njlin664/4-LayerPCB/hardware/README.md

Schematic:


PCB:
