njlin664/4-LayerPCB/docs/ad-4LPCB-2Dview.png

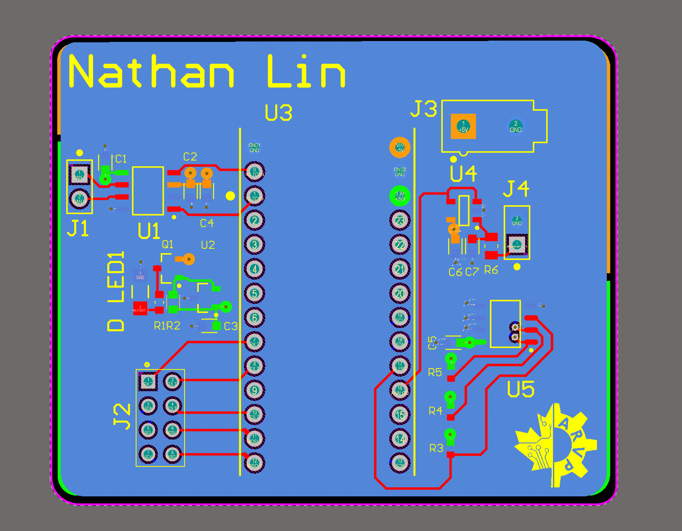
docs/ad-4LPCB-2Dview.png
