njlin664/4-LayerPCB/docs/ad-4LPCB-3Dback.png

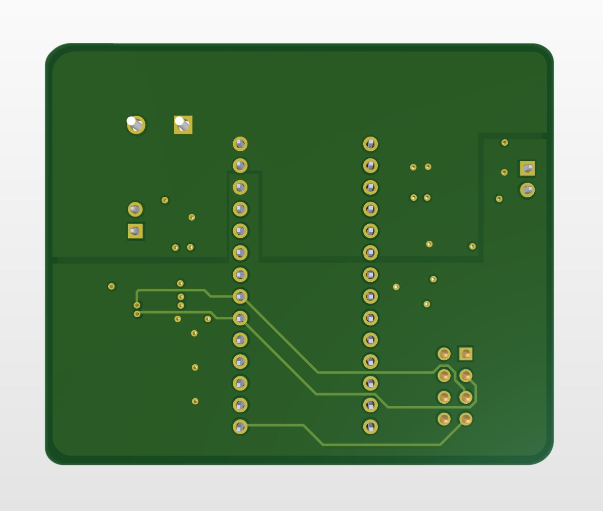
docs/ad-4LPCB-3Dback.png
