njlin664/4-LayerPCB/docs/ad-4LPCB-PCB.png

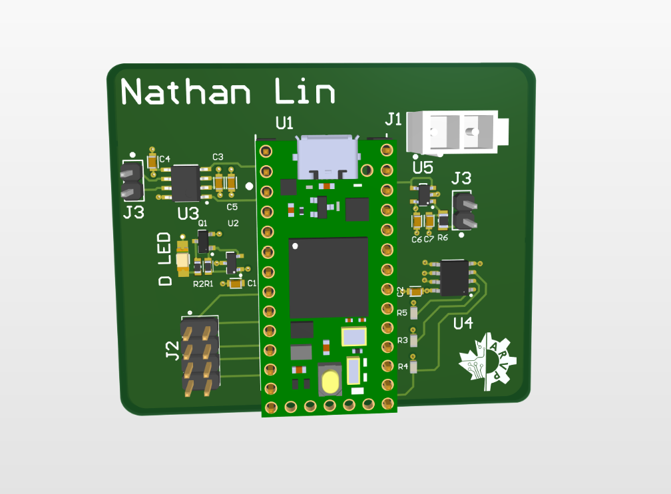
docs/ad-4LPCB-PCB.png
