njlin664/4-LayerPCB/docs/Screenshot 2026-10-11 235438.png

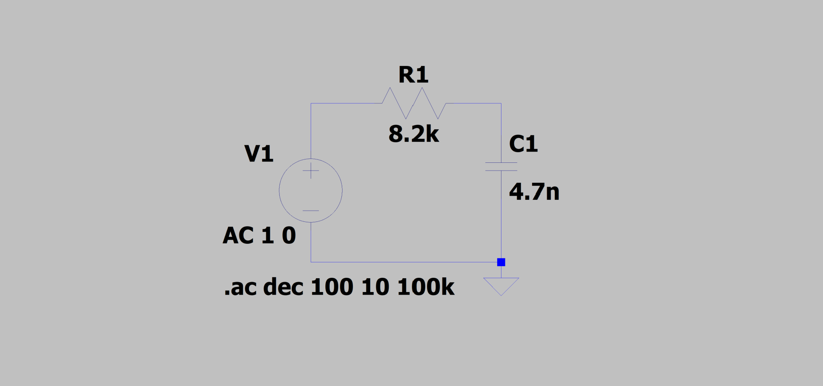
docs/Screenshot 2026-10-11 235438.png
