njlin664/4-LayerPCB/docs/Screenshot 2026-10-12 003222.png

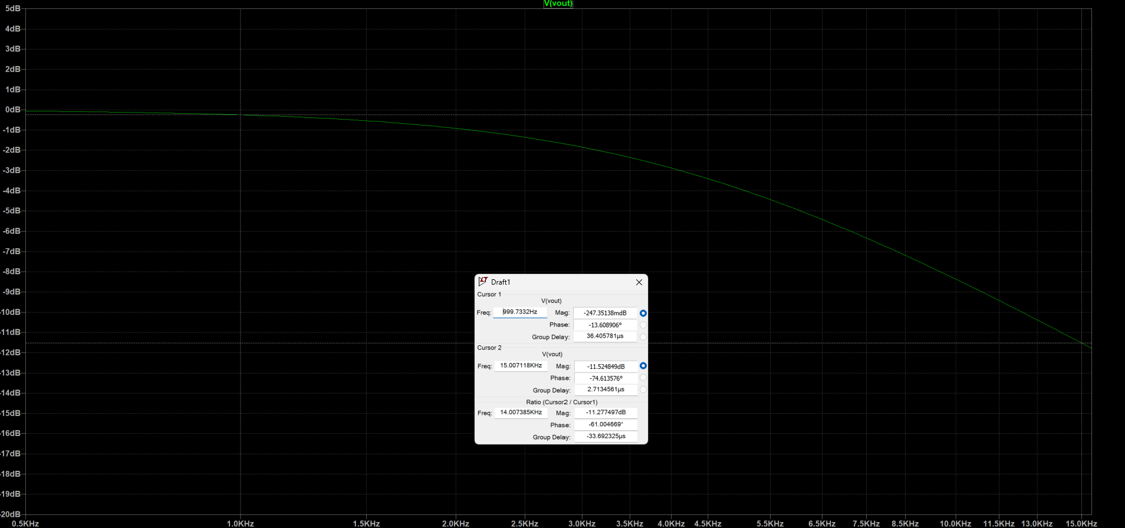
docs/Screenshot 2026-10-12 003222.png
