njlin664/4-LayerPCB/docs/Screenshot 2026-10-12 012424.png

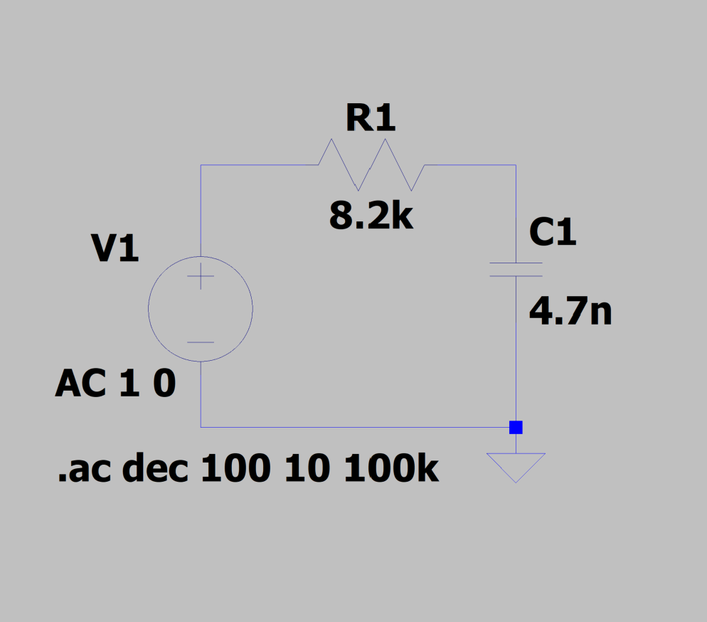
docs/Screenshot 2026-10-12 012424.png
