njlin664/4-LayerPCB/docs/Screenshot 2026-10-12 013154.png

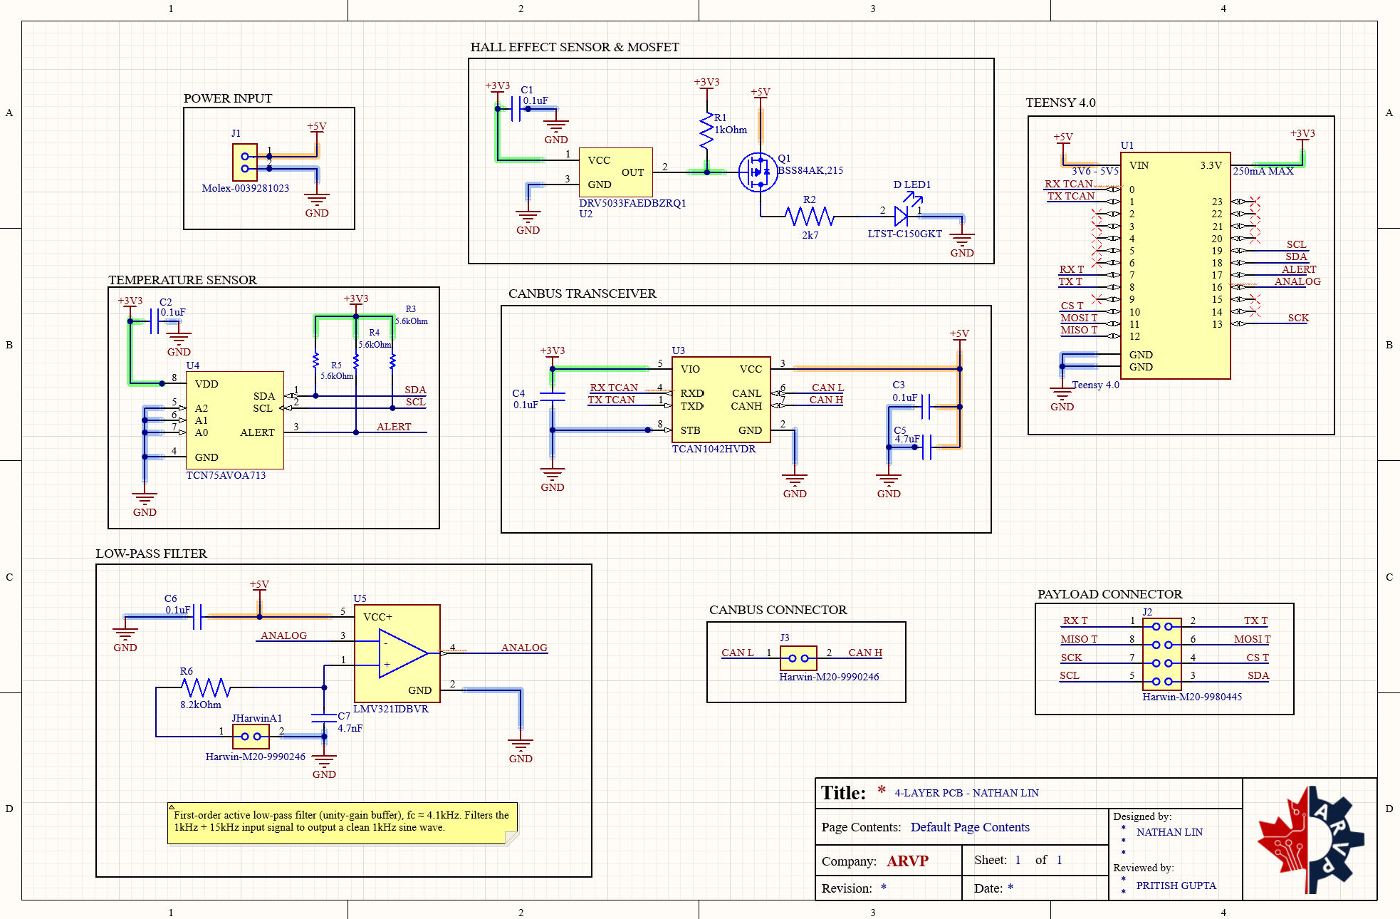
docs/Screenshot 2026-10-12 013154.png
