njlin664/4-LayerPCB/docs/Screenshot 2026-10-12 102839.png

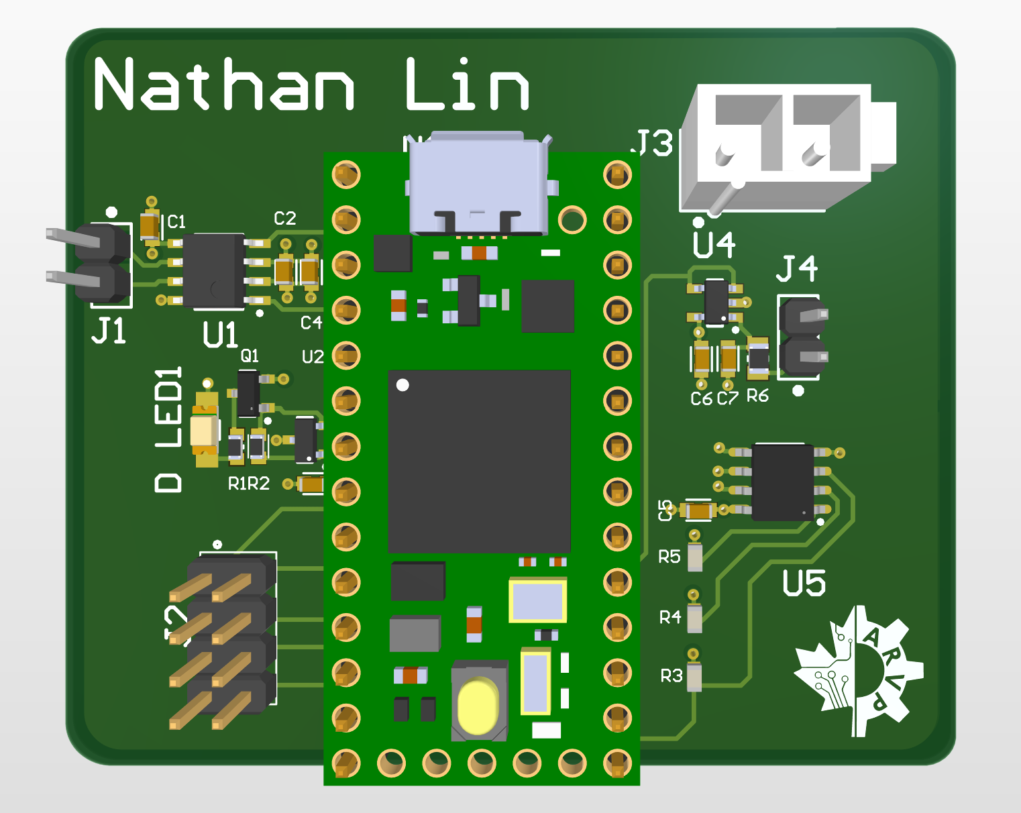
docs/Screenshot 2026-10-12 102839.png
