njlin664/4-LayerPCB/Draft1.asc

C1: cap; 4.7n
R1: res; 8.2k
V1: voltage; ""; AC 1 0
Named nets: 0, Vout
.ac dec 100 10 100k
