njlin664/4-LayerPCB/(list of files, drawings)

Other design files:
hardware/onboarding_nathanlin.PrjPcb
Table of Contents/Schematic_nathanlin.SchDoc
