njlin664/4-LayerPCB/(commit log)

2026-10-06 Update and rename projects/arvp/BOM.csv to Table of Contents/BOM.csv
2026-10-06 Rename projects/arvp/PCB_nathanlin.PcbDoc to Table of Contents/PCB_nathanlin.PcbDoc
2026-10-06 Rename projects/arvp/Schematic_nathanlin.SchDoc to Table of Contents/Schematic_nathanlin.SchDoc
2026-10-12 Rename Screenshot 2026-10-11 235438.png to LTspice test circuit for the low-pass filter
2026-10-12 Rename LTspice test circuit for the low-pass filter to LTspice test circuit for the low-pass filter,png
2026-10-12 Rename LTspice test circuit for the low-pass filter,png to LTspice test circuit for the low-pass filter.png
2026-10-12 Rename Screenshot 2026-10-12 003222.png to AC sweep of the low-pass filter.png
2026-10-12 Rename LTspice test circuit for the low-pass filter.png to lpf-ltspice-schematic.png
2026-10-12 Rename AC sweep of the low-pass filter.png to lpf-ac-sweep.png
2026-10-12 Rename Screenshot 2026-10-12 012424.png to lpf-ltspice-schematic.png
2026-10-12 Rename Screenshot 2026-10-12 013154.png to ad-4LPCB-schematic.png
2026-10-12 Rename Screenshot 2026-10-12 012818.png to ad-4LPCB-PCB.png
